2077762b/TeamEE4Project/Report/Appendices/can.tex

\begin{figure}[H]
\begin{center}
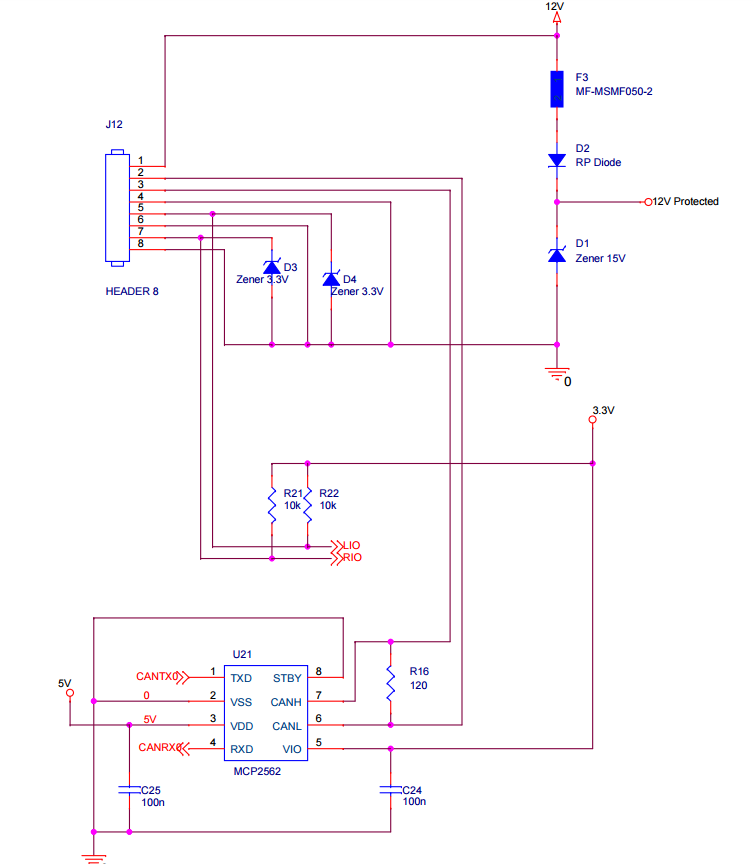
[picture p3: Report/Appendices/can.PNG]

\end{center}
\end{figure}
