2077762b/TeamEE4Project/Report/Appendices/gantt_chart.tex

\begin{figure}[H]
\begin{center}

\end{center}
\end{figure}
