2077762b/TeamEE4Project/Report/Appendices/LEDs_full.tex

\begin{figure}[H]
\begin{center}

\end{center}
\end{figure}
