2077762b/TeamEE4Project/Report/Appendices/microcontroller.tex

\begin{figure}[H]
\begin{center}

\end{center}
\end{figure}
