2077762b/TeamEE4Project/Report/Appendices/psu.tex

\begin{figure}[H]
\begin{center}
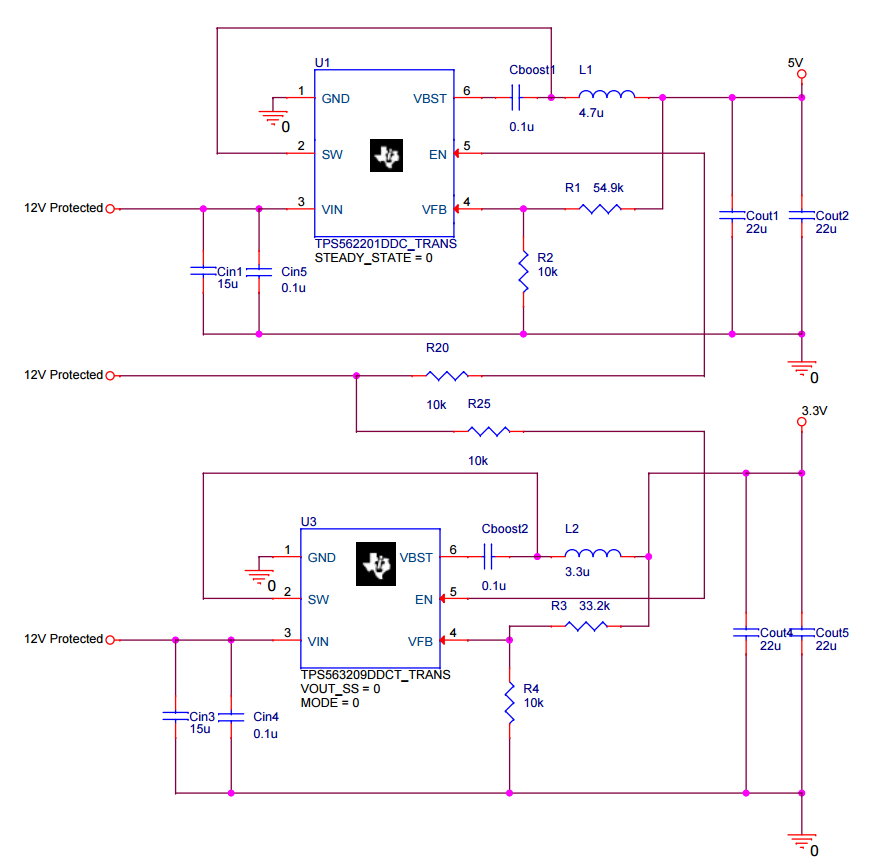
[picture p4: Report/Figures/psu.PNG]

\end{center}
\end{figure}
