2077762b/TeamEE4Project/Report/Figures/block_diagram.tex

\begin{figure}[H]
\begin{center}
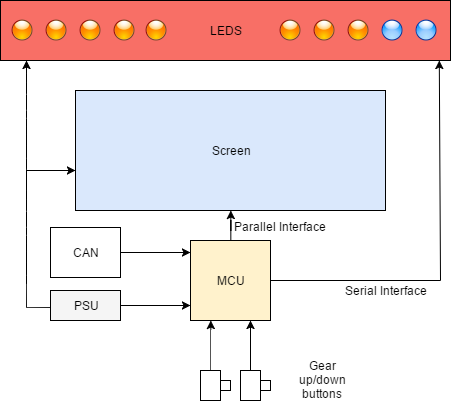
[picture p5: Report/Figures/refined_block_diagram.png]

\end{center}
\caption{High level device block diagram.}
\label{fig:block_diagram}
\end{figure}
