2077762b/TeamEE4Project/Report/Figures/can.tex

\begin{figure}[H]
\begin{center}

\end{center}
\caption{Circuit diagram of CAN unit.}
\label{fig:can}
\end{figure}
