2077762b/TeamEE4Project/Report/Figures/configuration_software.tex

\begin{figure}[H]
\begin{center}
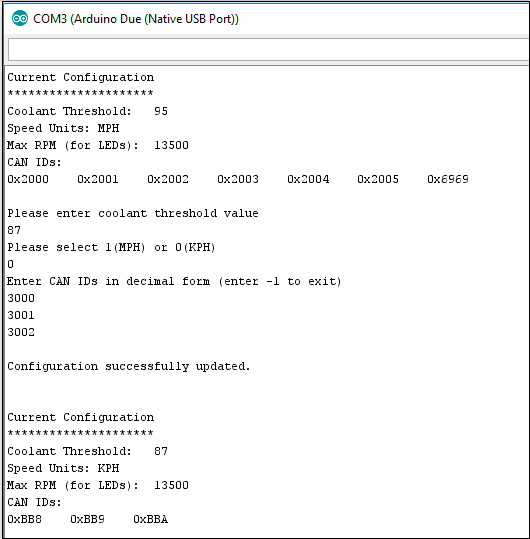
[picture p6: Report/Figures/configuration_software.png]

\end{center}
\caption{Example of Configuration Mode in use.}
\label{fig:configuration_software}
\end{figure}
