2077762b/TeamEE4Project/Report/Figures/device_back.tex

\begin{figure}[H]
\begin{center}
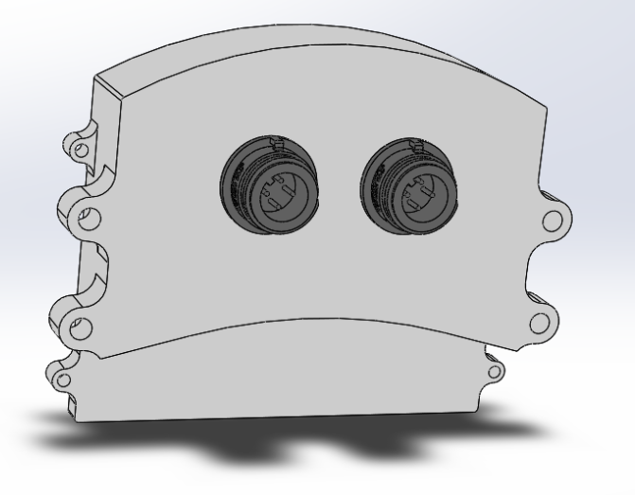
[picture p7: Report/Figures/device_back.png]

\end{center}
\caption{Bulgin connectors on the back of the device.}
\label{fig:device_back}
\end{figure}
