2077762b/TeamEE4Project/Report/Figures/device_render_expanded.tex

\begin{figure}[H]
\begin{center}
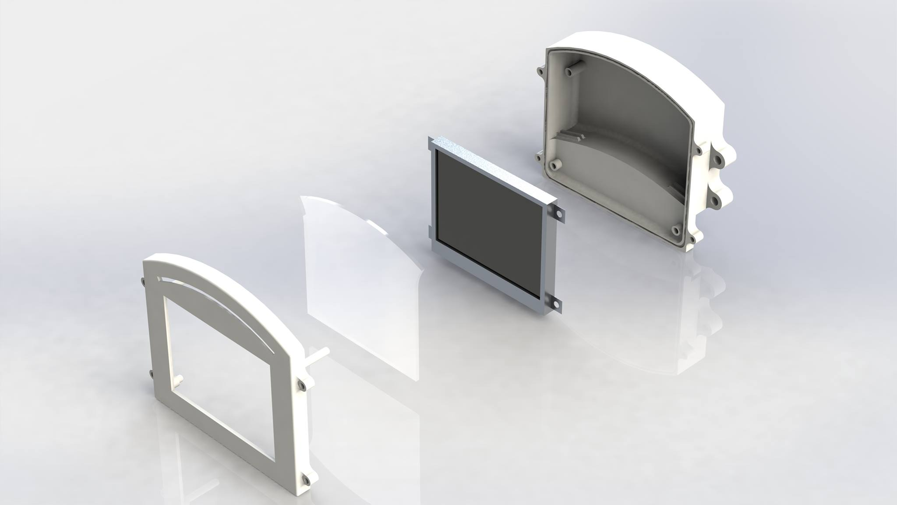
[picture p8: Report/Figures/device_render_expanded.jpg]

\end{center}
\caption{SolidWorks render of outer enclosure and display.}
\label{fig:device_render_expanded}
\end{figure}
