2077762b/TeamEE4Project/Report/Figures/device_render_wheel.tex

\begin{figure}[H]
\begin{center}
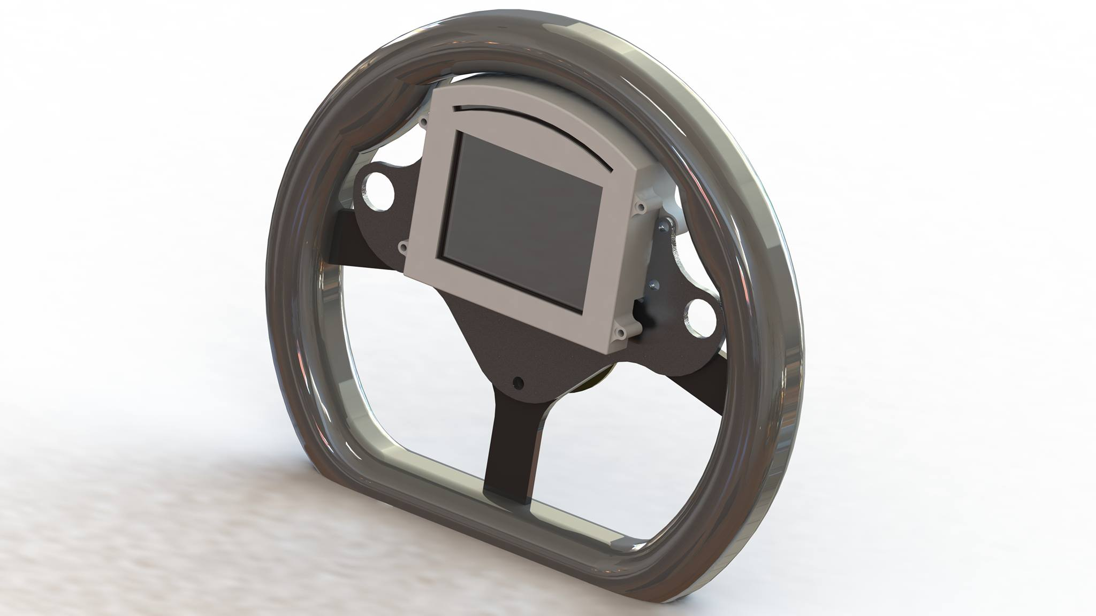
[picture p9: Report/Figures/device_render_wheel.jpg]

\end{center}
\caption{SolidWorks render of final device attached to steering wheel.}
\label{fig:device_render_wheel}
\end{figure}
