2077762b/TeamEE4Project/Report/Figures/diagnostics.tex

\begin{figure}[H]
\begin{center}
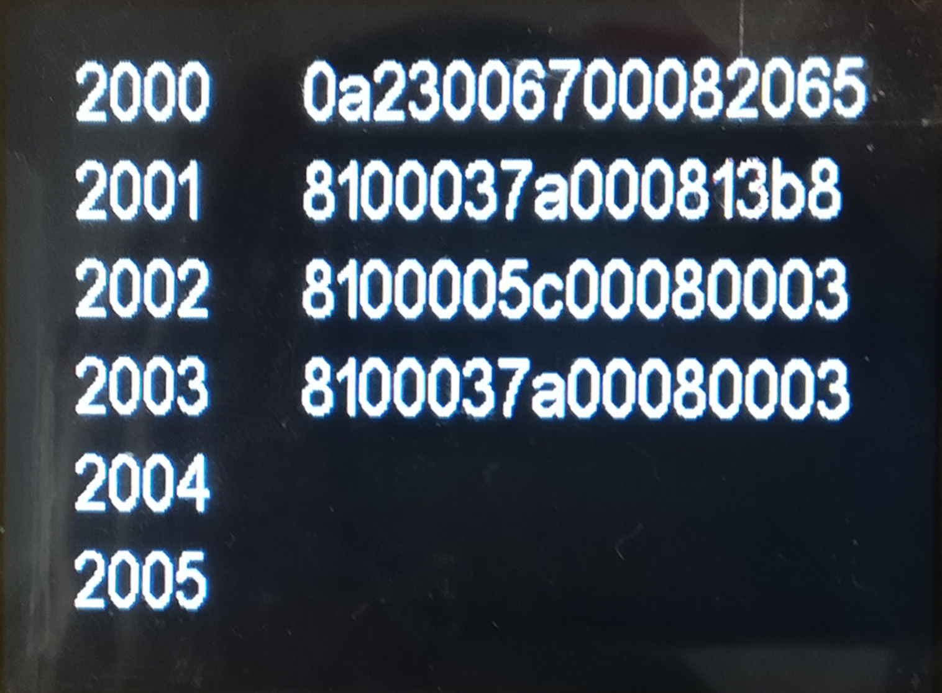
[picture p10: Report/Figures/diagnostics.png]

\end{center}
\caption{Device shown in Diagnostics Mode.}
\label{fig:diagnostics}
\end{figure}
