2077762b/TeamEE4Project/Report/Figures/display.tex

\begin{figure}[H]
\begin{center}
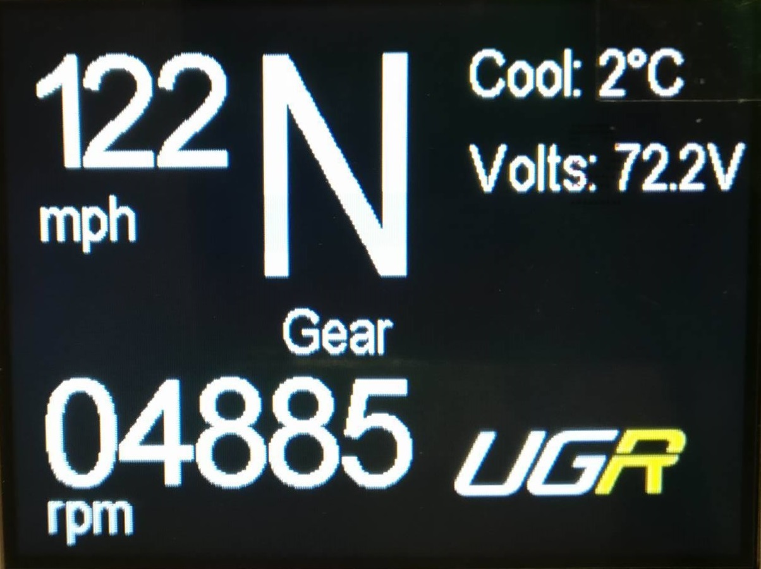
[picture p11: Report/Figures/display.jpg]

\end{center}
\caption{Device shown in Display Mode.}
\label{fig:display}
\end{figure}
