2077762b/TeamEE4Project/Report/Figures/full_leds.tex

\begin{figure}[H]
\begin{center}
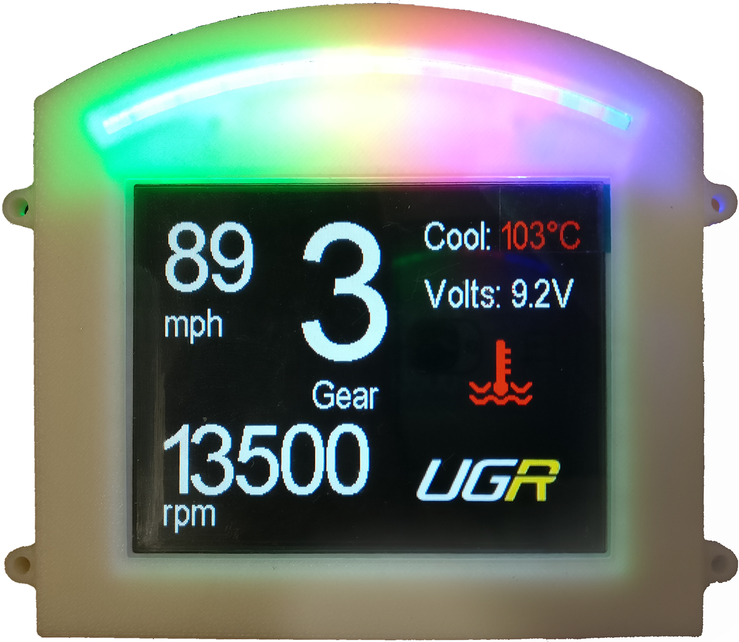
[picture p12: Report/Figures/full_leds.png]

\end{center}
\caption{LEDs displaying at full rpm.}
\label{fig:full_leds}
\end{figure}
