2077762b/TeamEE4Project/Report/Figures/leds_4.tex

\begin{figure}[H]
\begin{center}
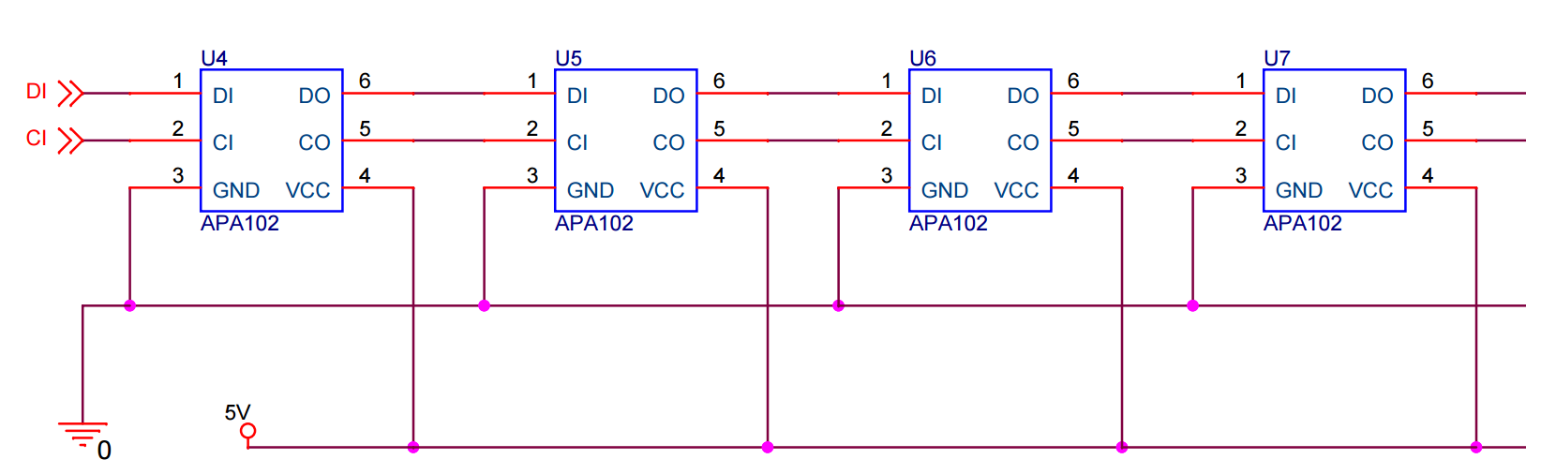
[picture p13: Report/Figures/leds_4.PNG]

\end{center}
\caption{Simplified circuit diagram of LEDs.}
\label{fig:leds_4}
\end{figure}
