2077762b/TeamEE4Project/Report/Figures/PCB.tex

\begin{figure}[H]
\centering
\begin{subfigure}{.5\textwidth}
  \centering
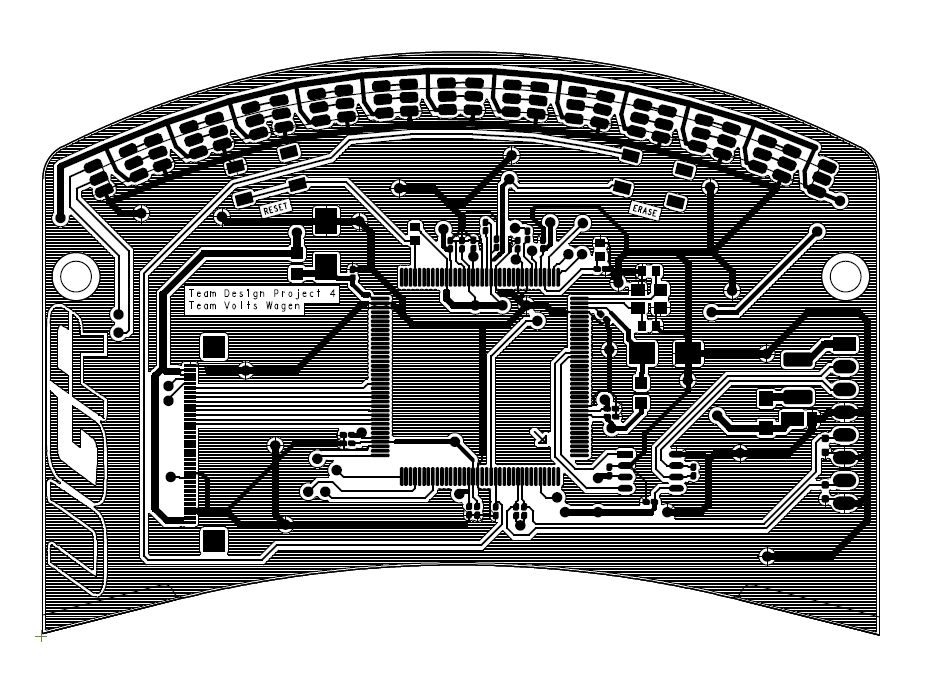
[picture p14: Report/Figures/PCB_front.png]
  
  \caption{PCB design front view.}
  \label{fig:PCB_front}
\end{subfigure}%
\begin{subfigure}{.5\textwidth}
  \centering
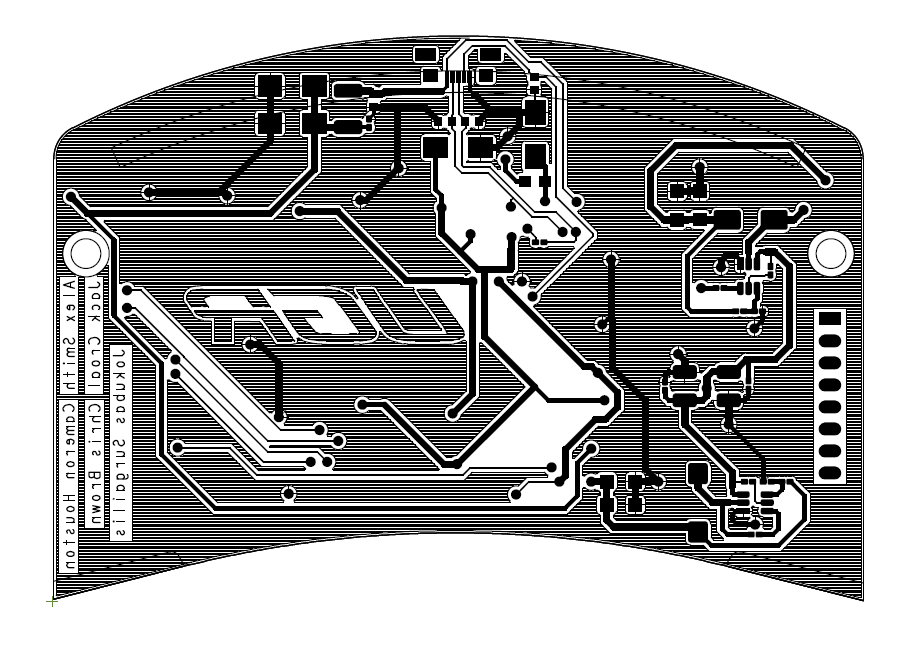
[picture p15: Report/Figures/PCB_back.png]
  
  \caption{PCB design rear view.}
  \label{fig:PCB_back}
\end{subfigure}
\caption{Overall PCB design for case.}
\label{fig:PCB}
\end{figure}
