2077762b/TeamEE4Project/Report/Figures/psu.tex

\begin{figure}[H]
\begin{center}

\end{center}
\caption{Circuit diagram of Power Supply Unit.}
\label{fig:psu}
\end{figure}
