2077762b/TeamEE4Project/Report/Figures/software_hierarchy.tex

\begin{figure}[H]
\begin{center}
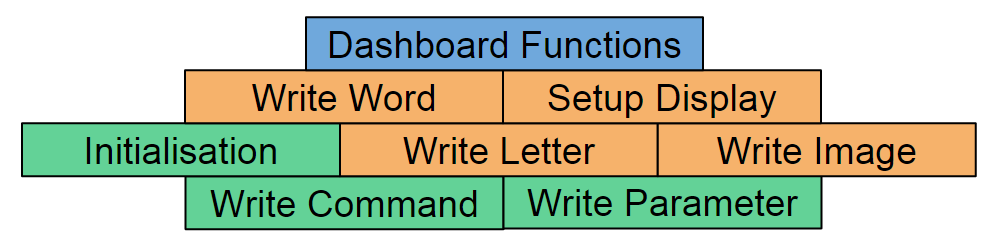
[picture p16: Report/Figures/software_hierarchy.PNG]

\end{center}
\caption{Software Implementation Hierarchy.}
\label{fig:software_hierarchy}
\end{figure}
