2077762b/TeamEE4Project/HeaderWriter/formula 1.jpg

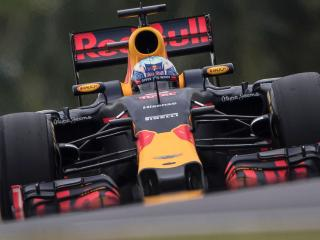
HeaderWriter/formula 1.jpg
