2077762b/TeamEE4Project/HeaderWriter/oil.jpg

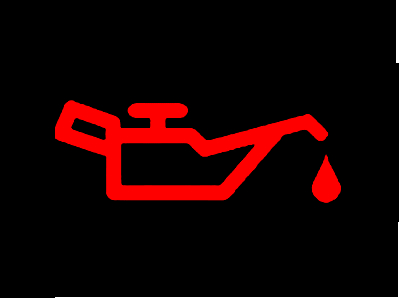
HeaderWriter/oil.jpg
