2077762b/TeamEE4Project/Report/Figures/block_diagram.jpg

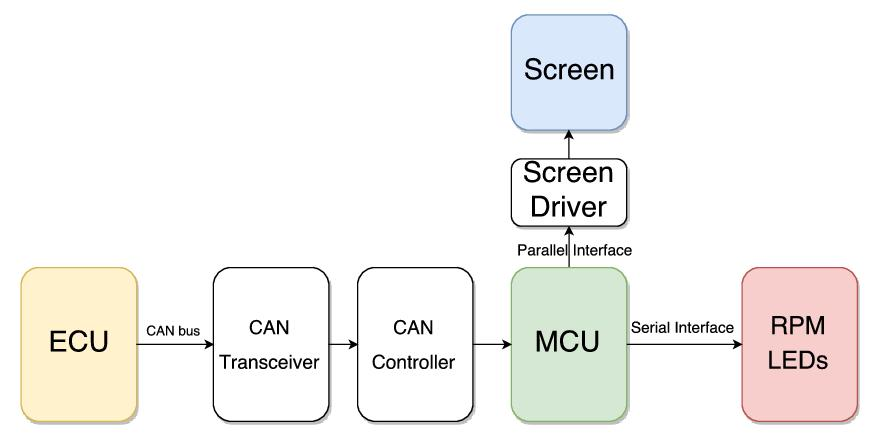
Report/Figures/block_diagram.jpg
