2077762b/TeamEE4Project/Report/Appendices/cost_sheet.tex

\begin{figure}[H]
\begin{center}

\end{center}
\end{figure}
