2077762b/TeamEE4Project/Report/Appendices/risk_register.tex

\begin{figure}[H]
\begin{center}
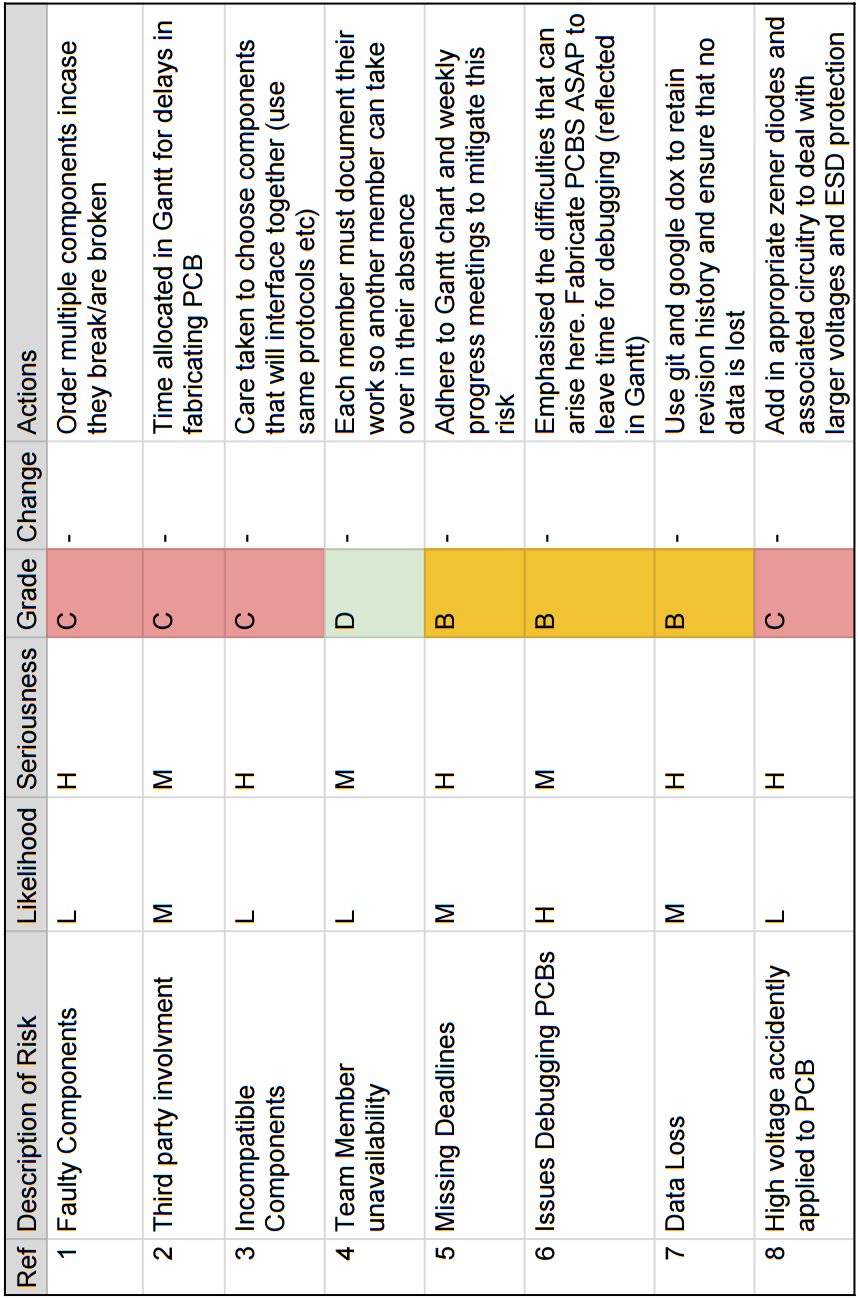
[picture p20: Report/Appendices/risk_register.PNG]

\end{center}
\end{figure}
