2077762b/TeamEE4Project/Report/Appendices/microcontroller.pdf

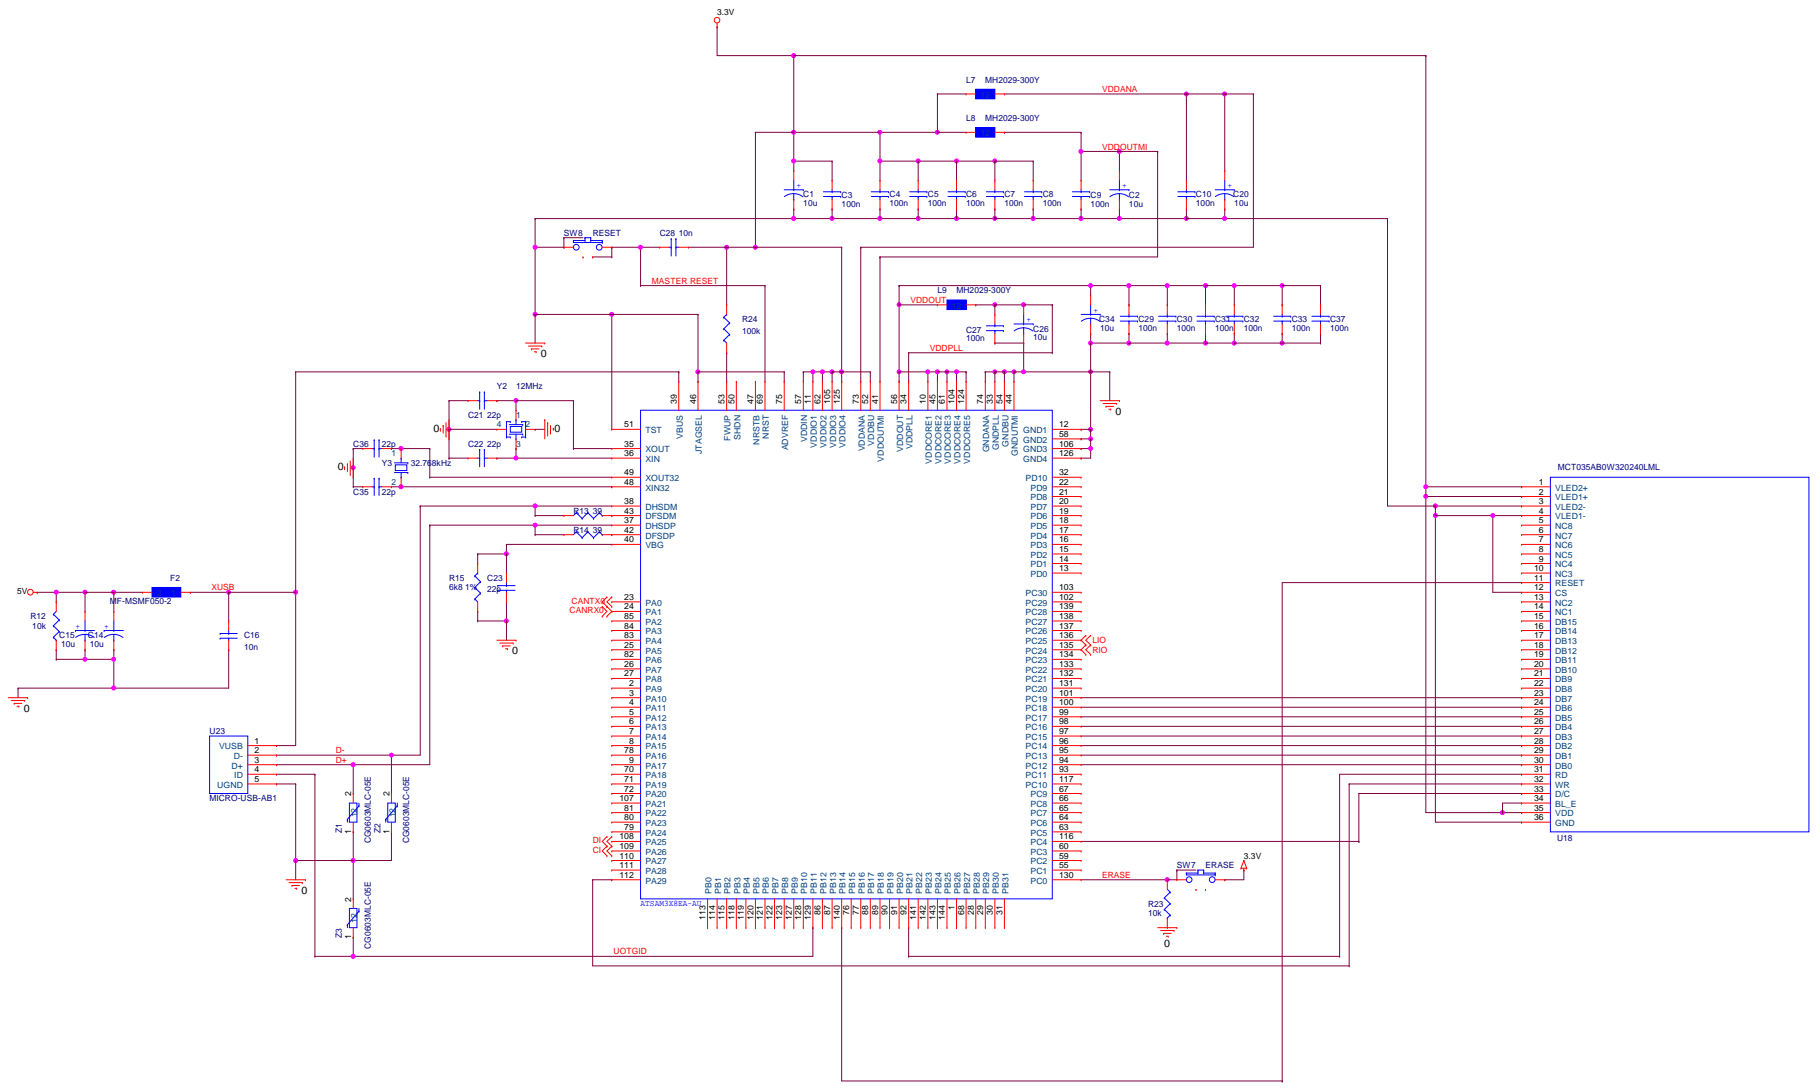
[picture p21: page 1]

MCT035AB0W320240LML
GND 36 VDD 35 BL_E 34 D/C 33 WR 32 RD 31 DB0 30 DB1 29 DB2 28 DB3 27 DB4 26 DB5 25 DB6 24 DB7 23 DB8 22 DB9 21 DB10 20 DB11 19 DB12 18 DB13 17 DB14 16 DB15 15 NC1 14 NC2 13 CS 12 RESET 11 NC3 10 NC4 9 NC5 8 NC6 7 NC7 6 NC8 5 VLED1- 4 VLED2- 3 VLED1+ 2 VLED2+ 1
