2077762b/TeamEE4Project/Report/Appendices/cost_sheet.pdf

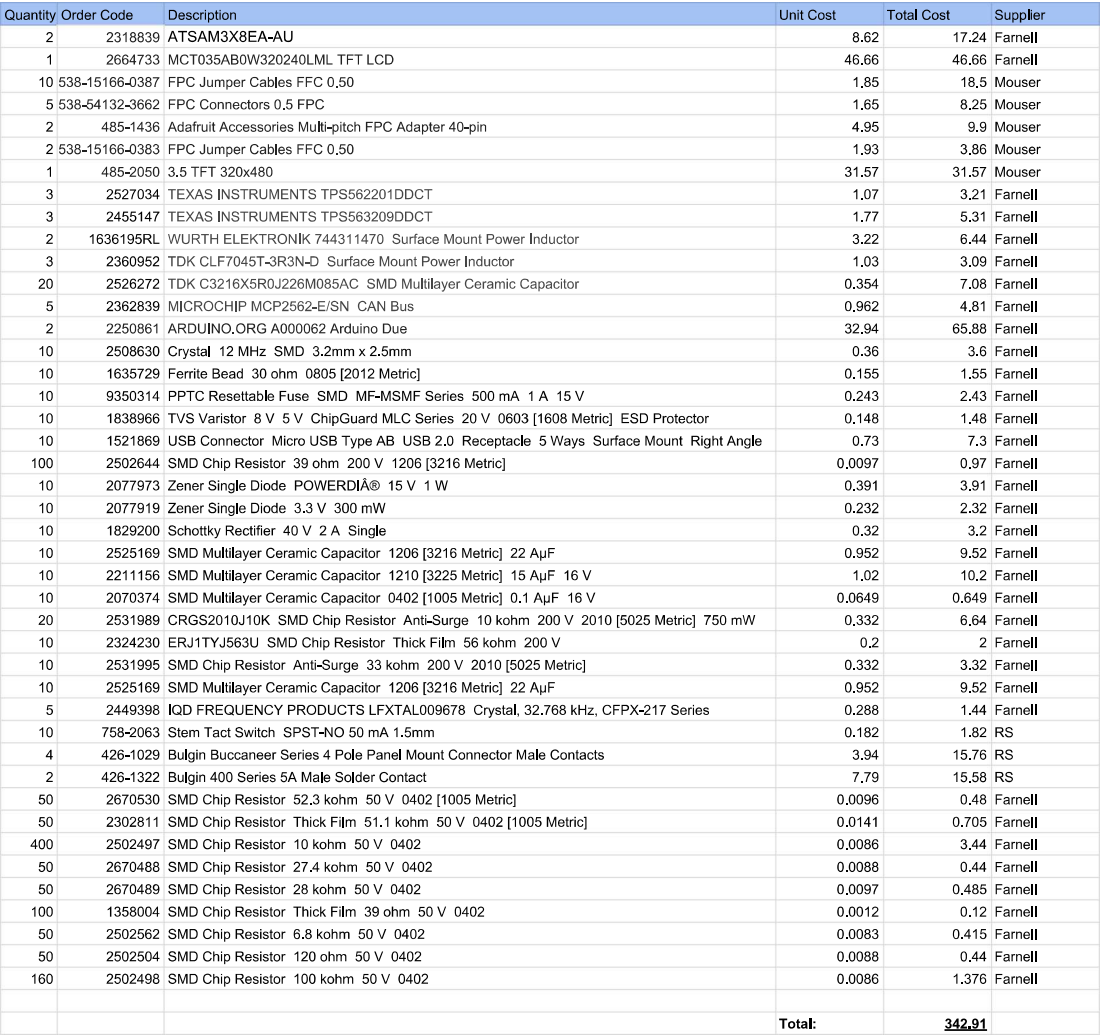
[picture p22: page 1]
