2077762b/TeamEE4Project/Report/Appendices/LEDs_full.pdf

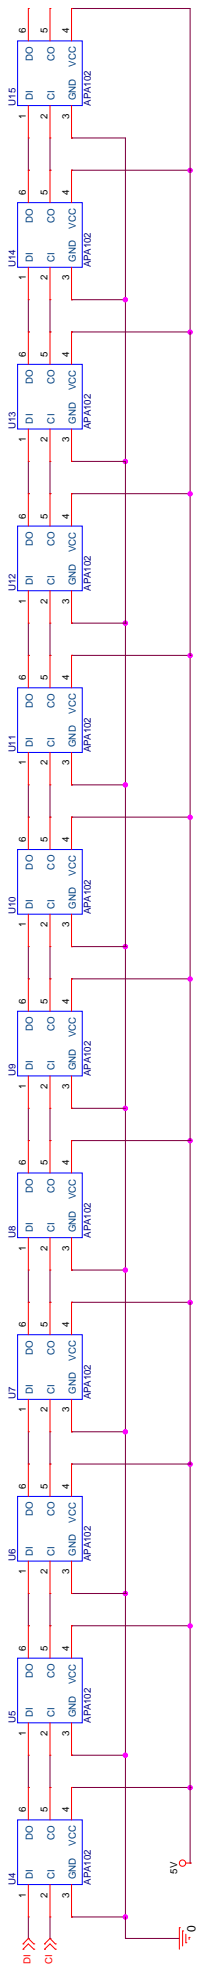
[picture p23: page 1]
