2077762b/TeamEE4Project/main/Letters24.h

#ifndef LETTERS24_H_  
#define LETTERS24_H_

const unsigned char percent_24[] = 
{
  0x38, 0x0C, 0x00, //   ###       ##   
  0x7C, 0x18, 0x00, //  #####     ##    
  0xEE, 0x18, 0x00, // ### ###    ##    
  0xC6, 0x18, 0x00, // ##   ##    ##     
  0xC6, 0x30, 0x00, // ##   ##   ##     
  0xC6, 0x30, 0x00, // ##   ##   ##     
  0xC6, 0x60, 0x00, // ##   ##  ##      
  0xEE, 0x60, 0x00, // ### ###  ##      
  0x7C, 0xC0, 0x00, //  #####  ##       
  0x38, 0xCE, 0x00, //   ###   ##  ###  
  0x01, 0x9F, 0x00, //        ##  ##### 
  0x01, 0xBB, 0x80, //        ## ### ###
  0x03, 0x31, 0x80, //       ##  ##   ##
  0x03, 0x31, 0x80, //       ##  ##   ##
  0x03, 0x31, 0x80, //       ##  ##   ##
  0x06, 0x31, 0x80, //      ##   ##   ##
  0x06, 0x3B, 0x80, //      ##   ### ###
  0x0C, 0x1F, 0x00, //     ##     ##### 
  0x0C, 0x0E, 0x00, //     ##      ###  
  0x00, 0x00, 0x00, //                  
  0x00, 0x00, 0x00, //                  
  0x00, 0x00, 0x00, //                  
  0x00, 0x00, 0x00, //                  
  0x00, 0x00, 0x00  //                  
};

const unsigned char colon_24[] = 
{
  0x00, //   
  0x00, //   
  0x00, //   
  0x00, //   
  0x00, //   
  0xC0, // ##
  0xC0, // ##
  0x00, //   
  0x00, //   
  0x00, //   
  0x00, //   
  0x00, //   
  0x00, //   
  0x00, //   
  0x00, //   
  0x00, //   
  0x00, //   
  0xC0, // ##
  0xC0, // ##
  0x00, //   
  0x00, //   
  0x00, //   
  0x00, //   
  0x00  //   
};

const unsigned char dot_24[] = 
{
  0x00, //   
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
  0x00, //        
  0x00, //        
  0x00, //        
  0x00, //        
  0x00, //        
  0x00, //        
  0x00, //        
  0x00, //        
  0x00, //        
  0x00, //        
  0x00, //        
  0x00, //        
  0x00, //        
  0x00, //        
  0x00  //        
};

#endif
