2077762b/TeamEE4Project/main/Numbers48.h

#ifndef NUMBERS48_H_  
#define NUMBERS48_H_

const unsigned char zero_48[] = 
{
  0x00, 0x1F, 0xE0, 0x00, //            ########           
  0x00, 0xFF, 0xFC, 0x00, //         ##############        
  0x01, 0xFF, 0xFE, 0x00, //        ################       
  0x03, 0xFF, 0xFF, 0x80, //       ###################     
  0x07, 0xFF, 0xFF, 0x80, //      ####################     
  0x0F, 0xF0, 0x3F, 0xC0, //     ########      ########    
  0x1F, 0xC0, 0x1F, 0xE0, //    #######         ########   
  0x1F, 0x80, 0x07, 0xE0, //    ######            ######   
  0x3F, 0x80, 0x07, 0xF0, //   #######            #######  
  0x3F, 0x00, 0x03, 0xF0, //   ######              ######  
  0x3F, 0x00, 0x03, 0xF0, //   ######              ######  
  0x7E, 0x00, 0x01, 0xF8, //  ######                ###### 
  0x7E, 0x00, 0x01, 0xF8, //  ######                ###### 
  0x7E, 0x00, 0x01, 0xF8, //  ######                ###### 
  0x7E, 0x00, 0x01, 0xF8, //  ######                ###### 
  0x7C, 0x00, 0x00, 0xF8, //  #####                  ##### 
  0xFC, 0x00, 0x00, 0xFC, // ######                  ######
  0xFC, 0x00, 0x00, 0xFC, // ######                  ######
  0xFC, 0x00, 0x00, 0xFC, // ######                  ######
  0xFC, 0x00, 0x00, 0xFC, // ######                  ######
  0xFC, 0x00, 0x00, 0xFC, // ######                  ######
  0xFC, 0x00, 0x00, 0xFC, // ######                  ######
  0xFC, 0x00, 0x00, 0xFC, // ######                  ######
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
  0x7E, 0x00, 0x03, 0xF0, //  ######               ######  
  0x7E, 0x00, 0x03, 0xF0, //  ######               ######  
  0x7F, 0x00, 0x03, 0xF0, //  #######              ######  
  0x3F, 0x00, 0x07, 0xE0, //   ######             ######   
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
};

#endif
