2077762b/TeamEE4Project/main/Numbers96.h

#ifndef NUMBERS96_H_  
#define NUMBERS96_H_

const unsigned char one_96[] = 
{
  0x00, 0x00, 0x00, 0x3F, 0xC0, //                           ########
  0x00, 0x00, 0x00, 0x7F, 0xC0, //                          #########
  0x00, 0x00, 0x00, 0x7F, 0xC0, //                          #########
  0x00, 0x00, 0x00, 0xFF, 0xC0, //                         ##########
  0x00, 0x00, 0x00, 0xFF, 0xC0, //                         ##########
  0x00, 0x00, 0x01, 0xFF, 0xC0, //                        ###########
  0x00, 0x00, 0x03, 0xFF, 0xC0, //                       ############
  0x00, 0x00, 0x07, 0xFF, 0xC0, //                      #############
  0x00, 0x00, 0x0F, 0xFF, 0xC0, //                     ##############
  0x00, 0x00, 0x0F, 0xFF, 0xC0, //                     ##############
  0x00, 0x00, 0x1F, 0xFF, 0xC0, //                    ###############
  0x00, 0x00, 0x3F, 0xFF, 0xC0, //                   ################
  0x00, 0x00, 0x7F, 0xFF, 0xC0, //                  #################
  0x00, 0x01, 0xFF, 0xFF, 0xC0, //                ###################
  0x00, 0x03, 0xFF, 0xFF, 0xC0, //               ####################
  0x00, 0x07, 0xFF, 0xFF, 0xC0, //              #####################
  0x00, 0x0F, 0xFF, 0xFF, 0xC0, //             ######################
  0x00, 0x3F, 0xFF, 0xFF, 0xC0, //           ########################
  0x00, 0x7F, 0xFF, 0xFF, 0xC0, //          #########################
  0x00, 0xFF, 0xFF, 0xFF, 0xC0, //         ##########################
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
  0xFF, 0xC0, 0x0F, 0xFE, 0x00, 0x00, 0x1F, 0xF8, // ##########          ###########                    ##########
  0xFF, 0xC0, 0x0F, 0xFE, 0x00, 0x00, 0x1F, 0xF8, // ##########          ###########                    ##########
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
};

#endif
