2077762b/TeamEE4Project/main/coolant.h

const unsigned char coolant_image [] = {
0x00, 0x00, 0x00, 0x00, 0x00, 0x00, 0x00, 0x00, 
0x00, 0x00, 0x00, 0x00, 0x00, 0x00, 0x00, 0x00, 
0x00, 0x00, 0x00, 0x00, 0x00, 0x00, 0x00, 0x00, 
0x00, 0x00, 0x00, 0x00, 0x00, 0x00, 0x00, 0x00, 
0x00, 0x00, 0x00, 0x00, 0x00, 0x00, 0x00, 0x00, 
0x00, 0x00, 0x00, 0x00, 0x00, 0x00, 0x00, 0x00, 
0x00, 0x01, 0x00, 0x03, 0x02, 0x00, 0x08, 0x03, 
0x00, 0x06, 0x00, 0x00, 0x0A, 0x03, 0x00, 0x0A, 
0x01, 0x00, 0x0F, 0x00, 0x00, 0x0D, 0x00, 0x00, 
0x0A, 0x00, 0x04, 0x04, 0x00, 0x00, 0x01, 0x04, 
0x00, 0x00, 0x06, 0x00, 0x03, 0x02, 0x00, 0x03, 
0x00, 0x00, 0x07, 0x00, 0x00, 0x04, 0x00, 0x00, 
0x01, 0x00, 0x00, 0x00, 0x00, 0x00, 0x00, 0x00, 
0x00, 0x00, 0x00, 0x00, 0x00, 0x00, 0x00, 0x00, 
0x00, 0x00, 0x00, 0x01, 0x00, 0x00, 0x01, 0x00, 
0x00, 0x00, 0x00, 0x00, 0x00, 0x00, 0x00, 0x00, 
0x00, 0x00, 0x00, 0x00, 0x01, 0x00, 0x00, 0x01, 
0x00, 0x00, 0x01, 0x00, 0x00, 0x01, 0x00, 0x00, 
0x00, 0x00, 0x00, 0x00, 0x00, 0x00, 0x00, 0x00, 
0x00, 0x00, 0x00, 0x00, 0x00, 0x00, 0x00, 0x00, 
0x00, 0x00, 0x00, 0x00, 0x00, 0x00, 0x00, 0x00, 
0x00, 0x00, 0x00, 0x00, 0x00, 0x00, 0x00, 0x00, 
0x00, 0x00, 0x00, 0x00, 0x00, 0x00, 0x00, 0x00, 
0x00, 0x00, 0x00, 0x00, 0x00, 0x00, 0x00, 0x00, 
0x08, 0x09, 0x04, 0x01, 0x00, 0x00, 0x05, 0x00, 
0x01, 0x11, 0x05, 0x05, 0x10, 0x00, 0x00, 0x22, 
0x00, 0x00, 0x35, 0x00, 0x00, 0x42, 0x00, 0x00, 
0x3E, 0x00, 0x00, 0x30, 0x00, 0x00, 0x1D, 0x01, 
0x00, 0x08, 0x00, 0x00, 0x0E, 0x07, 0x01, 0x04, 
0x00, 0x00, 0x04, 0x00, 0x00, 0x06, 0x02, 0x03, 
0x01, 0x00, 0x00, 0x00, 0x00, 0x00, 0x00, 0x00, 
0x00, 0x00, 0x00, 0x00, 0x00, 0x00, 0x00, 0x00, 
0x00, 0x00, 0x00, 0x01, 0x00, 0x00, 0x01, 0x00, 
0x00, 0x00, 0x00, 0x00, 0x00, 0x00, 0x00, 0x00, 
0x00, 0x00, 0x00, 0x00, 0x01, 0x00, 0x00, 0x01, 
0x00, 0x00, 0x01, 0x00, 0x00, 0x01, 0x00, 0x00, 
0x00, 0x00, 0x00, 0x00, 0x00, 0x00, 0x00, 0x00, 
0x00, 0x00, 0x00, 0x00, 0x00, 0x00, 0x00, 0x00, 
0x00, 0x00, 0x00, 0x00, 0x00, 0x00, 0x00, 0x00, 
0x00, 0x00, 0x00, 0x00, 0x00, 0x00, 0x00, 0x00, 
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
};
