2077762b/TeamEE4Project/main/Numbers24.h

#ifndef NUMBERS24_H_  
#define NUMBERS24_H_

const unsigned char zero_24[] = 
{
  0x1E, 0x00, //    ####   
  0x3F, 0x00, //   ######  
  0x73, 0x80, //  ###  ### 
  0x61, 0x80, //  ##    ## 
  0x40, 0xC0, //  #      ##
  0xC0, 0xC0, // ##      ##
  0xC0, 0xC0, // ##      ##
  0xC0, 0xC0, // ##      ##
  0xC0, 0xC0, // ##      ##
  0xC0, 0xC0, // ##      ##
  0xC0, 0xC0, // ##      ##
  0xC0, 0xC0, // ##      ##
  0xC0, 0xC0, // ##      ##
  0xC0, 0xC0, // ##      ##
  0xC0, 0x80, // ##      # 
  0x61, 0x80, //  ##    ## 
  0x73, 0x80, //  ###  ### 
  0x3F, 0x00, //   ######  
  0x1E, 0x00, //    ####   
  0x00, 0x00, //           
  0x00, 0x00, //           
  0x00, 0x00, //           
  0x00, 0x00, //           
  0x00, 0x00  //           
};

const unsigned char one_24[] = 
{
  0x0C,   //     ##
  0x0C,   //     ##
  0x1C,   //    ###
  0x3C,   //   ####
  0x7C,   //  #####
  0xCC,   // ##  ##
  0x8C,   // #   ##
  0x0C,   //     ##
  0x0C,   //     ##
  0x0C,   //     ##
  0x0C,   //     ##
  0x0C,   //     ##
  0x0C,   //     ##
  0x0C,   //     ##
  0x0C,   //     ##
  0x0C,   //     ##
  0x0C,   //     ##
  0x0C,   //     ##
  0x0C,   //     ##
  0x00,   //       
  0x00,   //       
  0x00,   //       
  0x00,   //       
  0x00    //       
};

const unsigned char two_24[] = 
{
  0x1E, 0x00, //    ####   
  0x3F, 0x80, //   ####### 
  0x61, 0x80, //  ##    ## 
  0xE0, 0xC0, // ###     ##
  0xC0, 0xC0, // ##      ##
  0xC0, 0xC0, // ##      ##
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
  0xC1, 0x80, // ##     ## 
  0xC1, 0x80, // ##     ## 
  0x63, 0x80, //  ##   ### 
  0x7F, 0x00, //  #######  
  0x3C, 0x00, //   ####    
  0x00, 0x00, //           
  0x00, 0x00, //           
  0x00, 0x00, //           
  0x00, 0x00, //           
  0x00, 0x00  //
};    


#endif
