2077762b/TeamEE4Project/main/dash_functions.h

#ifndef DASH_FUNCTIONS_H_  
#define DASH_FUNCTIONS_H_

#include <due_can.h>

#include "Display_driver.h"
#include "formula1.h"
#include "coolant.h"
#include "ugr.h"
#include "config.h"
#include "LEDs.h"

#define CAN_ID_START 25
#define CAN_VALUE_START 105
#define MAX_FRAME_SIZE 16

void setup_screen();

void setup_page(int page_number);
void update_diagnostics(CAN_FRAME frame);
void setup_diagnostics_mode();
void setup_display_mode();

void update_cool(int level);
void update_mph(int level);
void update_rpm(int level);
void update_gear(int level);
void update_volts(int level);
void set_coolant(int state);

#endif
