2077762b/TeamEE4Project/main/Fonts.ino

#include "Fonts.h"

void setup_font_24(){
  
  font_24[48] = {zero_24, 10};
  font_24[49] = {one_24, 6};
  font_24[50] = {two_24, 10};
  font_24[51] = {three_24, 10};
  font_24[52] = {four_24, 11};
  font_24[53] = {five_24, 10};
  font_24[54] = {six_24, 10};
  font_24[55] = {seven_24, 10};
  font_24[56] = {eight_24, 10};
  font_24[57] = {nine_24, 10};

  font_24[65] = {A_24,15};
  font_24[66] = {B_24,13};
  font_24[67] = {C_24,14};
  font_24[68] = {D_24,13};
  font_24[69] = {E_24,12};
  font_24[70] = {F_24, 11};
  font_24[71] = {G_24, 15};
  font_24[79] = {O_24, 15};
  font_24[86] = {V_24, 15};

  font_24[37] = {percent_24, 17};   // %
  font_24[39] = {degree_24, 7};     // '
  font_24[46] = {dot_24, 2};        // .
  font_24[58] = {colon_24, 2};      // :

  font_24[97]  = {a_24, 10};
  font_24[98]  = {b_24, 10};
  font_24[99]  = {c_24, 9};
  font_24[100] = {d_24, 10};
  font_24[101] = {e_24, 10};
  font_24[102] = {f_24, 7}; 
  font_24[104] = {h_24, 10};
  font_24[105] = {i_24, 2};
  font_24[107] = {k_24, 9};
  font_24[108] = {l_24, 2};
  font_24[109] = {m_24, 16};
  font_24[110] = {n_24, 10};
  font_24[111] = {o_24, 10};
  font_24[112] = {p_24, 10};
  font_24[114] = {r_24, 6};
  font_24[115] = {s_24, 9};
  font_24[116] = {t_24, 5};
  font_24[117] = {u_24, 10};
}

void setup_font_48(){
  
  font_48[48] = {zero_48, 30};
  font_48[49] = {one_48, 17};
  font_48[50] = {two_48, 30};
  font_48[51] = {three_48, 30};
  font_48[52] = {four_48, 32};
  font_48[53] = {five_48, 30};
  font_48[54] = {six_48, 31};
  font_48[55] = {seven_48, 30};
  font_48[56] = {eight_48, 30};
  font_48[57] = {nine_48, 30};

} 

void setup_font_96(){
  
  font_96[48] = {n_96, 61};
  font_96[49] = {one_96, 34};
  font_96[50] = {two_96, 61};
  font_96[51] = {three_96, 61};
  font_96[52] = {four_96, 65};
  font_96[53] = {five_96, 61};
  font_96[54] = {six_96, 63};
  font_96[55] = {seven_96, 61};
  font_96[56] = {eight_96, 61};
} 
 
