2077762b/TeamEE4Project/(commit log)

2017-02-03 Added Display Code. Can currently display numbers 0 to 9
2017-02-03 added functionality for Rev Leds
2017-03-02 CAN stuff added to - pages not currently working
2017-03-08 Fixed screen layout, CAN diagnostics not currently working
    [Can.ino, config.h, config.ino, dash_functions.h, dash_functions.ino, main.ino]
2017-03-13 Added extra letters needed to represent hexadecimal. Updated diagnostic display so bytes are displayed in correct order
    [Can.ino, Fonts.ino, Letters24.h, dash_functions.h, dash_functions.ino, main.ino]
2017-03-14 More work done - errors in CAN and screen discovered
    [Can.ino, dash_functions.ino, main.ino]
2017-03-16 Latest changes to bug fix CAN
    [main.ino]
2017-03-16 Fixed some of the CAN issues
    [Can.ino, dash_functions.ino, header_writer.c, main.ino]
2017-03-16 Removed LEDs folder
2017-03-16 Displayed volts on the screen
2017-03-16 LED software written
2017-03-16 Fixed pin bug
2017-03-16 LEDs now working properly!
2017-03-16 Gear location changed
2017-03-20 Changes to Serial print and configuration mode
2017-03-20 Missed spacing in serial print
    [config.ino]
2017-03-31 PIN configuration changed for test board
2017-04-13 Code for testing CAN on big prototype PCM
2017-04-19 LEDs now work with main spi bus
2017-05-15 Fixes to sending software
    [dash_functions.ino, main.ino]
